nyan07/aura/README.md

# Arte-Luz-Interatividade: uma abordagem do uso da tecnologia na arte e da luz como material

Este repositório contém o meu trabalho de conclusão de curso do Bacharelado 
em Artes Visuais da Universidade Federal do Rio Grande do Sul - UFRGS.

Foi desenvolvido um trabalho que reune aplicações de arte e tecnologia 
utilizando Microsoft Kinect (input), Arduino (output) e um computador para
orquestrar o funcionamento destes dispositivos.

Trata-se de uma obra de arte interativa onde LEDs (presos ao teto em uma grade) 
acendem e apagam de acordo com a presença do espectador.

## Organização de diretórios
- `app` scripts em Processing referente ao trabalho prático
- `latex` monografia escrita em latex
- `talk` apresentação para a banca https://nyan07.github.io/aura/
