nyan07/aura/latex/03-elementos-pos-textuais/apendices.tex

%
% Documento: Apêndices
%

\begin{apendicesenv}

\chapter{Fotos da instalação}
\label{app:instalacao}

As fotos foram registradas após a apresentação final do trabalho, na Pinacoteca Barão de Santo Ângelo, com os interatores que estavam presentes.

\begin{figure}[H]
  \begin{center}
    \caption{Interações com o público em ambiente com baixa luminosidade 1}
    \vspace*{0,2cm}
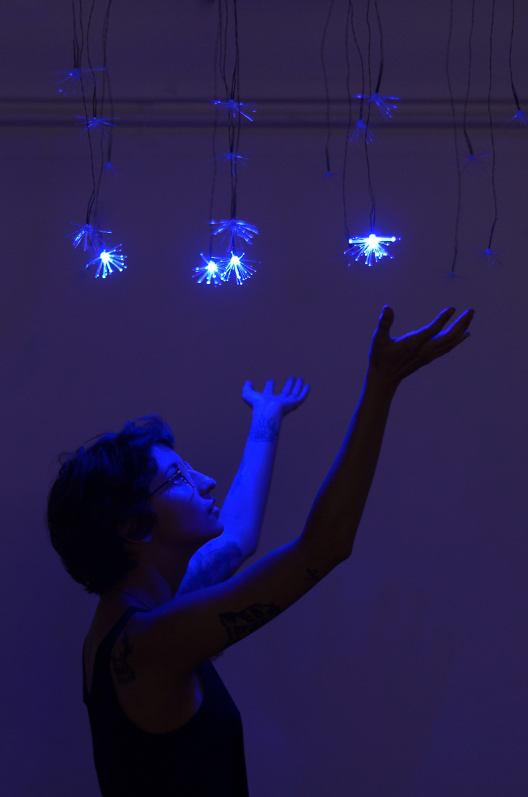
[picture p13: latex/04-figuras/instalacao_1.jpg]
    
    \label{fig:instalacao_1}
  \end{center}
  \vspace*{-0,9cm}
  \fonte{Elaborada pela autora}\\
\end{figure}

\begin{figure}[H]
  \begin{center}
    \caption{Interações com o público em ambiente com baixa luminosidade 2}
    \vspace*{0,2cm}
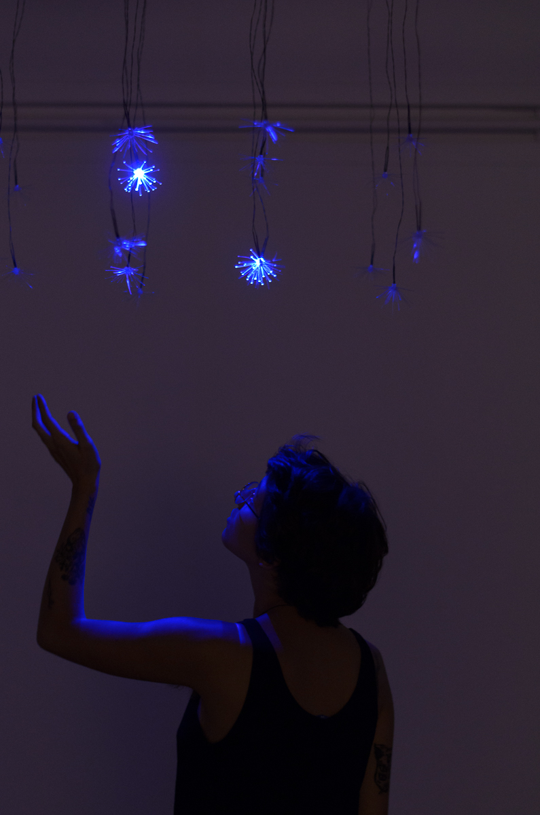
[picture p14: latex/04-figuras/instalacao_2.jpg]
    
    \label{fig:instalacao_2}
  \end{center}
  \vspace*{-0,9cm}
  \fonte{Elaborada pela autora}\\
\end{figure}

\begin{figure}[H]
  \begin{center}
    \caption{Interações com o público em ambiente com baixa luminosidade 3}
    \vspace*{0,2cm}
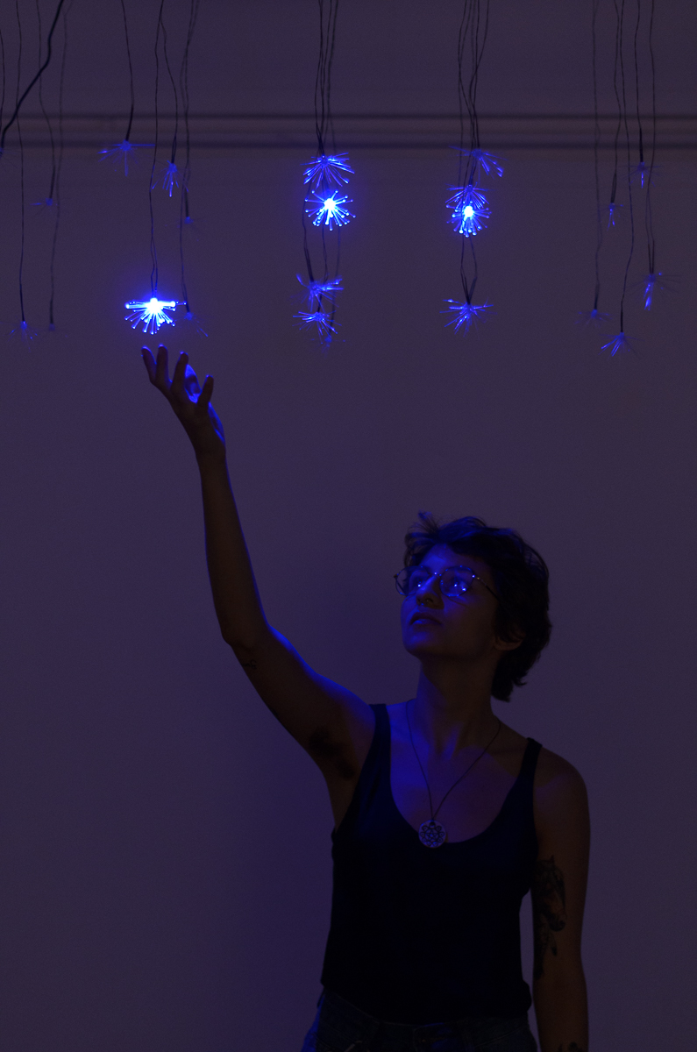
[picture p15: latex/04-figuras/instalacao_3.jpg]
    
    \label{fig:instalacao_3}
  \end{center}
  \vspace*{-0,9cm}
  \fonte{Elaborada pela autora}\\
\end{figure}

\begin{figure}[H]
  \begin{center}
    \caption{Interações com o público em ambiente com baixa luminosidade 4}
    \vspace*{0,2cm}
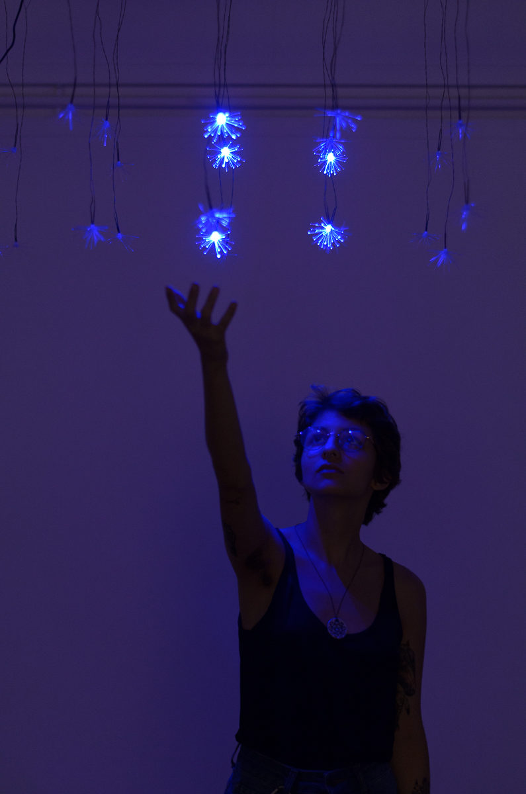
[picture p16: latex/04-figuras/instalacao_4.jpg]
    
    \label{fig:instalacao_4}
  \end{center}
  \vspace*{-0,9cm}
  \fonte{Elaborada pela autora}\\
\end{figure}

\begin{figure}[H]
  \begin{center}
    \caption{Vista da instalação em ambiente com baixa luminosidade}
    \vspace*{0,2cm}
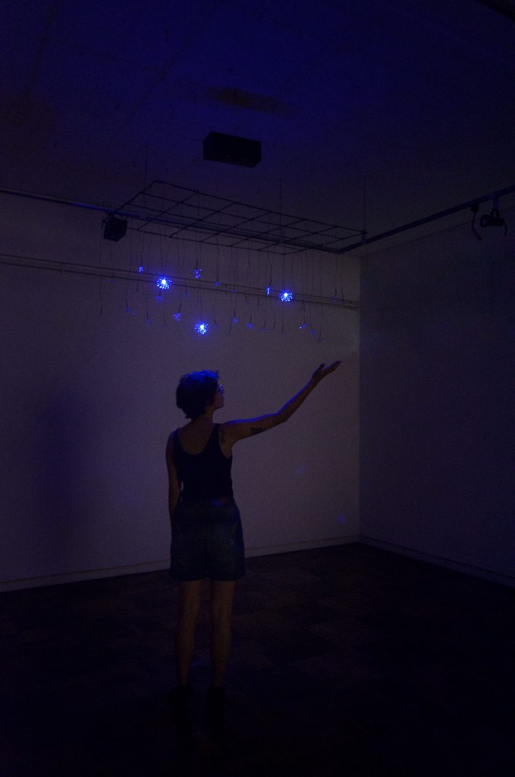
[picture p17: latex/04-figuras/instalacao_5.jpg]
    
    \label{fig:instalacao_5}
  \end{center}
  \vspace*{-0,9cm}
  \fonte{Elaborada pela autora}\\
\end{figure}

\begin{figure}[H]
  \begin{center}
    \caption{Interações com o público em ambiente com alta luminosidade 1}
    \vspace*{0,2cm}
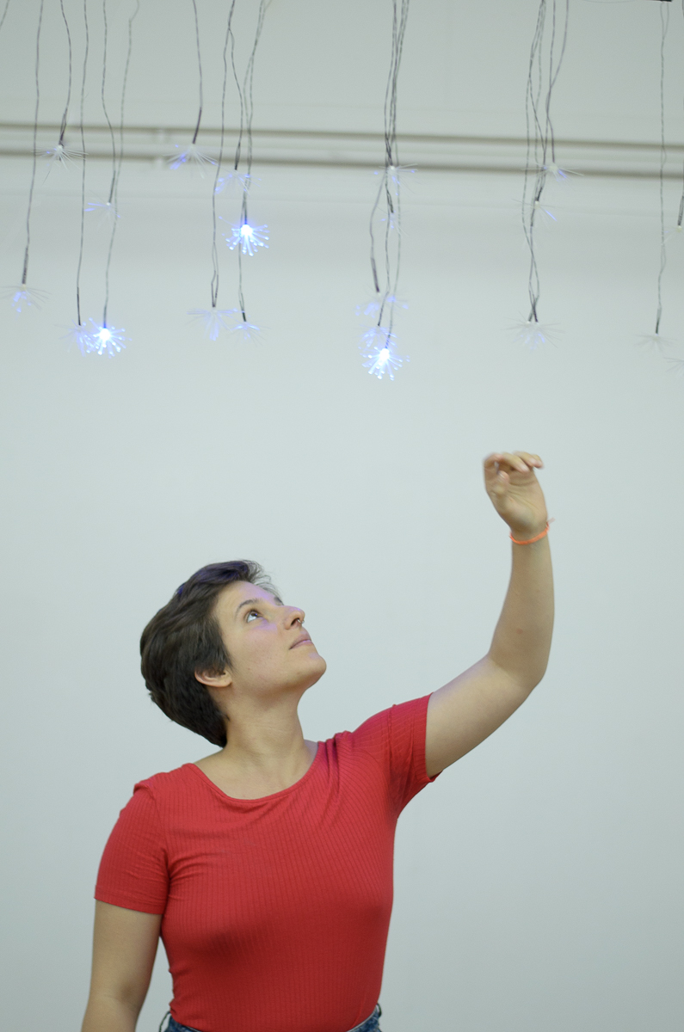
[picture p18: latex/04-figuras/instalacao_6.jpg]
    
    \label{fig:instalacao_6}
  \end{center}
  \vspace*{-0,9cm}
  \fonte{Elaborada pela autora}\\
\end{figure}

\begin{figure}[H]
  \begin{center}
    \caption{Interações com o público em ambiente com alta luminosidade 2}
    \vspace*{0,2cm}
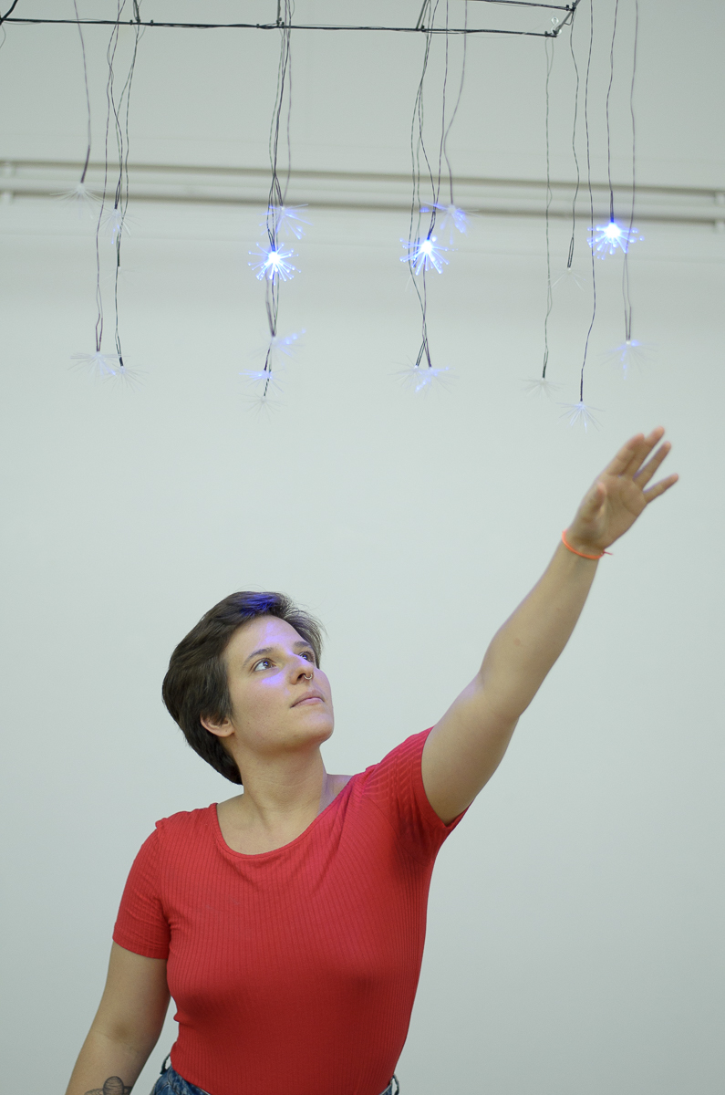
[picture p19: latex/04-figuras/instalacao_7.jpg]
    
    \label{fig:instalacao_7}
  \end{center}
  \vspace*{-0,9cm}
  \fonte{Elaborada pela autora}\\
\end{figure}

\begin{figure}[H]
  \begin{center}
    \caption{Vista da instalação em ambiente com alta luminosidade}
    \vspace*{0,2cm}
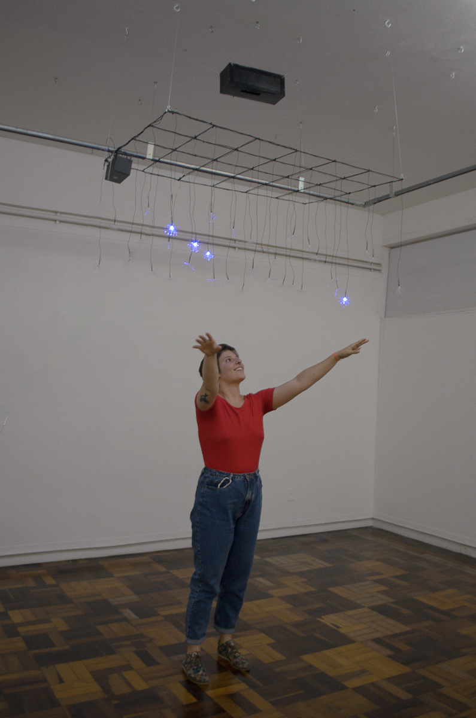
[picture p20: latex/04-figuras/instalacao_8.jpg]
    
    \label{fig:instalacao_8}
  \end{center}
  \vspace*{-0,9cm}
  \fonte{Elaborada pela autora}\\
\end{figure}

\end{apendicesenv}
