nyan07/aura/latex/01-elementos-pre-textuais/listaSiglas.tex

%
% Documento: Lista de abreviaturas e siglas
%

\begin{siglas}
  \setlength{\baselineskip}{0.7\baselineskip}
  
  \item[FPS] \textit{Frames per Second} (Quadros por Segundo)
  \item[IDE] \textit{Integrated Development Environment} (Ambiente de Desenvolvimento Integrado)
  \item[IR] Infrared radiation (Radiação infravermelha)
  \item[LED] \textit{Light-emitting Diode} (Diodo Emissor de Luz)
  \item[RGB] R. \textit{Red}: Vermelho, G. \textit{Green}: Verde, B. \textit{Blue}: Azul
  \item[UFRGS] Universidade Federal do Rio Grande do Sul
  \item[USB] \textit{Universal Serial Bus}
\end{siglas}
