nyan07/aura/latex/01-elementos-pre-textuais/capa.tex

%
% Documento: Capa
%

\makeatletter
\begin{capa}
	\thispagestyle{empty}%limpa estilo da pagina
	\setlength{\baselineskip}{0.72\baselineskip}
    \begin{center} %Alinhamento centralizado
	
    \textbf{\expandafter\uppercase\expandafter{\imprimirinstituicao}}\\
    \textbf{\expandafter\uppercase\expandafter{\imprimirdepartamento}}\\
    \textbf{\expandafter\uppercase\expandafter{\imprimirprograma}}\\
	\vspace*{5cm}%Espaçamento entre linhas

	\large\textbf{\expandafter\uppercase\expandafter{\imprimirtitulotb}}{:}
	\large\textbf{\expandafter\uppercase\expandafter{\imprimirsubtitulo}}\\
	
	\vspace*{6cm}%Espaçamento entre linhas	
	\small\textbf{\expandafter\uppercase\expandafter{\imprimirnomeautor}}\\
	\vspace*{9cm}%%Espaçamento entre linhas
	\small\textbf{\expandafter\uppercase\expandafter{\imprimirlocal}}\\
	\small\textbf{\expandafter\uppercase\expandafter{\imprimirdata}}\\		
	\end{center} %Alinhamento centralizado
\end{capa}
\makeatother
