nyan07/aura/latex/01-elementos-pre-textuais/folhaAprovacao.tex

%
% Documento: FOLHA APROVAÇÃO
%

\makeatletter
\begin{folhadeaprovacao}

\thispagestyle{empty}%limpa estilo da pagina
	
	\begin{center}
    
		\small\textbf{\expandafter\uppercase\expandafter{\imprimirnomeautor}}\\
		\vspace*{8.2 cm}%Espaço entre linhas
		\normalsize\textbf{\expandafter\uppercase\expandafter{\imprimirtitulotb}}{:}
		\normalsize\textbf{\expandafter\uppercase\expandafter{\imprimirsubtitulo}}\\
    \end{center}
	
	\vspace*{0.35 cm}%Espaçamento entre linhas
		    \large%tamanho da fonte 
    		\hfill%Estica horizontamente  com espaços
	    	\begin{minipage}{8 cm}%Minipagina
	    		\begin{small} %Muda tamanho da fonte
	    		\setlength{\baselineskip}{0.7\baselineskip}
				
				{Trabalho de conclusão apresentado à banca do Curso de {\imprimircurso} – {\imprimirprograma } do {\imprimirdepartamento} da {\imprimirinstituicao}, como requisito obrigatório para obtenção do título de {\imprimirgrau} em {\imprimircurso}.}\\
				
				\end{small} %Muda tamanho da fonte
		    \end{minipage}%%Minipagina

		    \vspace*{0.6 cm}%Espaçamento entre linhas
		    
		    \large%%tamanho da fonte 
    		\hfill%%Estica horizontamente  com espaços

		    \normalsize %Muda tamanho da fonte
		    \vspace*{1.5 cm}%Espaçamento entre linhas
		    
		    %\begin{minipage}{9 cm }%%Minipagina
		    
		    \noindent{Porto Alegre,}{ }{\imprimirdataapresentacao}\\
		    %\end{minipage}%Minipagina
			
          % \begin{center}%Alinhamento centralizado
		   % \vspace*{1.21 cm}%Espaçamento entre linhas
		   % \textbf{Banca Examinadora}\\ %Negrito
						
			\vspace*{2 cm}%Espaçamento entre linhas
			\noindent\rule{9 cm}{.1 mm}\\
			\imprimirtitulacaoorientador{ }\imprimirorientador{ }- Orientador\\
			
			\vspace*{1 cm}%Espaçamento entre linhas
			\noindent\rule{9 cm}{.1 mm}\\
			\imprimirtitulacaoexamum{ }\imprimirnmexamum{ }- Banca examinadora\\
				
			\vspace*{1 cm}%Espaçamento entre linhas
			\noindent\rule{9 cm}{.1 mm}\\	
			\imprimirtitulacaoexamdois{ }\imprimirnomeexamdois{ }- Banca examinadora\\			

\end{folhadeaprovacao}
\makeatother
