nyan07/aura/latex/06-quadros/quaexemplo.tex

\begin{quadro}[H]

	\begin{center}
	\caption{Exemplo para quadro.\label{qua:quaexe}}
		\begin{tabular}{|p{7cm}|p{7cm}|}
			\hline
			("Trabalho Conclusão de Curso")\\
			\hline
		\end{tabular}
	\end{center}
	\vspace*{-0,8cm}

	{\raggedright \fonte{Autor desta monografia, 2015.}}
	
\end{quadro}
