nyan07/aura/latex/01-elementos-pre-textuais/agradecimentos.tex

\begin{agradecimento}

Agradeço à Desiree Santos e ao Igor Balteiro que colaboraram com a execução da obra apresentada. Sem suas contribuições, ideias e incentivo este trabalho não seria possível. 

À ThoughtWorks pelo espaço na sala Mão na Massa, onde trabalhei ao longo do ano, e por ceder parte dos equipamentos utilizados.

À Gisele Ramires que teve papel fundamental na minha jornada durante a graduação e muito mais que uma colega, se tornou uma amiga. 

Ao Felipe de Morais por me incentivar, apoiar e acreditar em mim. 

Ao Ricardo Cantergi pelo carinho e suporte nos momentos mais difíceis que tive nos últimos anos do curso. 

Agradeço também aos membros da banca pelo tempo dedicado. Profa. Dra. Alessandra Lucia Bochio e Profa. Dra. Marina Bortoluz Polidoro, que através de pontuações incríveis agregaram valor imensurável a este trabalho.

Ao meu orientador, Alberto, pela confiança depositada.

\end{agradecimento}
