nyan07/aura/latex/01-elementos-pre-textuais/preambulo.tex

%
% Documento: Preâmbulo
%

\instituicao{Universidade Federal do Rio Grande do Sul}
\abreviatura{UFRGS}
\departamento{Instituto de Artes}
\local{Porto Alegre}
\programa{Bacharelado em Artes Visuais}
\nomeautor{Daniela Feitosa Araújo}
\titulotb{Arte-Luz-Interatividade}
\subtitulo{Uma abordagem do uso da tecnologia na arte e da luz como material}
\data{2018}
\grau{Bacharel}
\dataapresentacao{dezembro de 2018}
\curso{Artes Visuais}

%Dados Orientador
\orientador{Alberto Marinho Ribas Semeler}
%\coorientador{Anderson Black}
\instOrientador{UFRGS}
\departamentoorientador{Artes Visuais}
\titulacaoorientador{Prof. Dr.}

%Dados Examinador 1
\nmexamum{Alessandra Lucia Bochio}
\instexamum{UFRGS}
\departamentoexamum{Instituto de Artes}
\titulacaoexamum{Profa. Dra.}

%Dados Examinador 2
\nomeexamdois{Marina Bortoluz Polidoro}
\instexamdois{UFRGS}
\departamentoexamdois{Instituto de Artes}
\titulacaoexamdois{Profa. Dra.}
