nyan07/aura/latex/01-elementos-pre-textuais/epigrafe.tex

%
% Documento: Epígrafe
%
\thispagestyle{empty}
\begin{epigrafe}

"Às vezes olhar para o futuro pode ser assustador porque por definição ele é desconhecido. Mas com arte e tecnologia podemos contar histórias reais sobre o que está por vir e trazer nitidez para essas questões."
{\\}{\\}

\begin{autorepigrafe}
Andrew McWilliams - TEDxVilnius
\end{autorepigrafe}

\end{epigrafe}
