nyan07/aura/latex/01-elementos-pre-textuais/listaAlgoritmos.tex

%
% Documento: Lista de algoritmos
%

\newcommand{\algoritmoname}{Algoritmo}
\renewcommand{\listalgorithmcfname}{Lista de Algoritmos}

\floatname{algocf}{\algoritmoname}
\newlistof{listofalgoritmos}{loa}{\listalgoritmoname}
\newlistentry{algocf}{loa}{0}

\counterwithout{algocf}{chapter}
\renewcommand{\cftalgocfname}{\algoritmoname\space}
\renewcommand*{\cftalgocfaftersnum}{\hfill--\hfill}

\pdfbookmark[0]{\listalgorithmcfname}{loa}
\listofalgorithms
\cleardoublepage
