nyan07/aura/latex/01-elementos-pre-textuais/listaFiguras.tex

%
% Documento: Lista de figuras
%

\pdfbookmark[0]{\listfigurename}{lof}
\listoffigures*
\cleardoublepage
