nyan07/aura/latex/01-elementos-pre-textuais/listaSimbolos.tex

%
% Documento: Lista de símbolos
%

\begin{simbolos}
    \item[$ \Gamma $] Letra grega Gama
    \item[$ \lambda $] Comprimento de ondada
    \item[$ \in $] Pertence
\end{simbolos}
