nyan07/aura/latex/04-figuras/jim_campbell.jpg

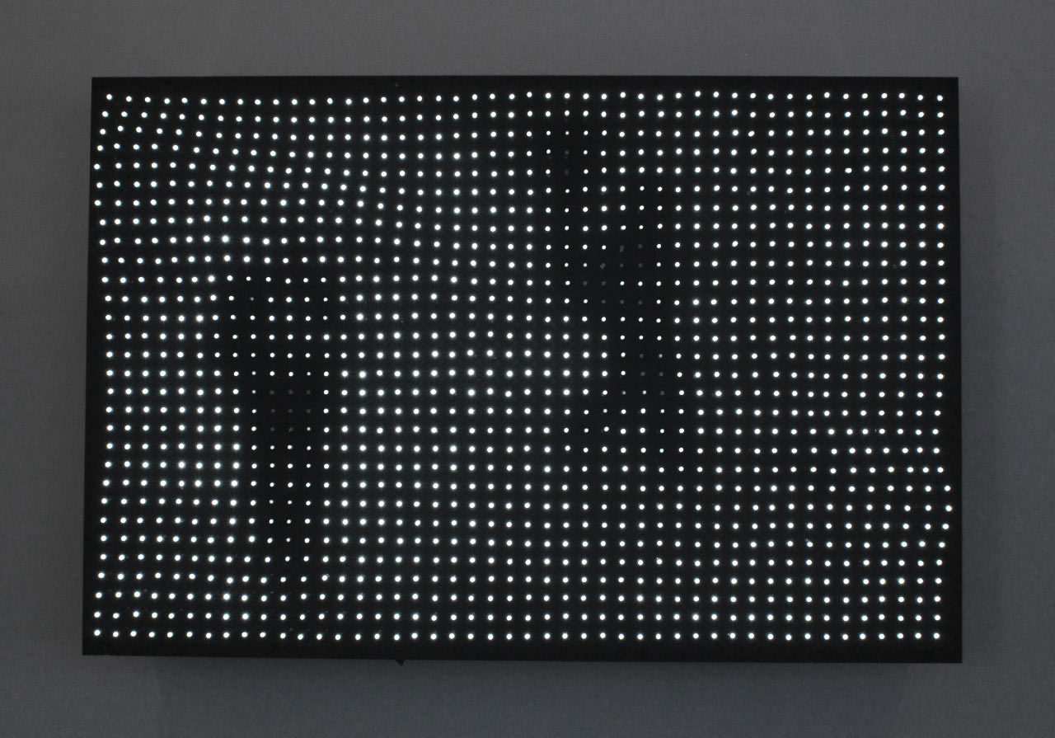
latex/04-figuras/jim_campbell.jpg
