nyan07/aura/latex/04-figuras/leds.jpg

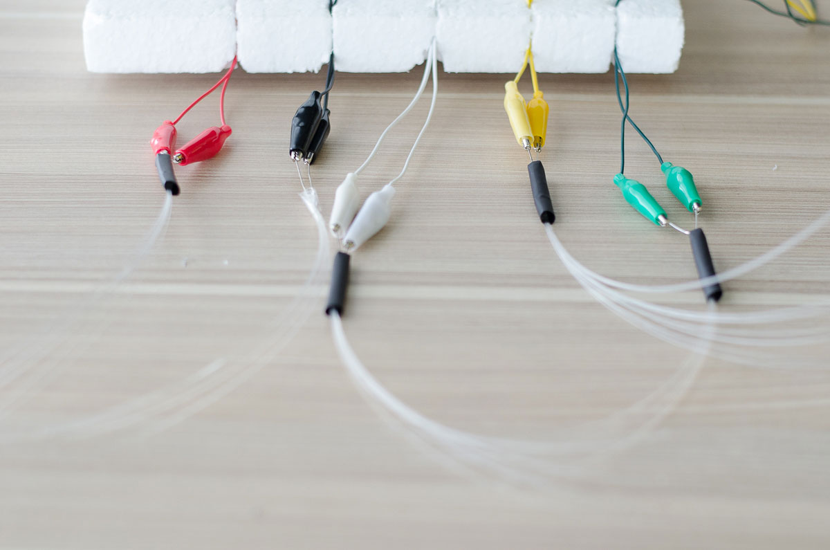
latex/04-figuras/leds.jpg
