nyan07/aura/latex/04-figuras/seurat_la_parede.jpg

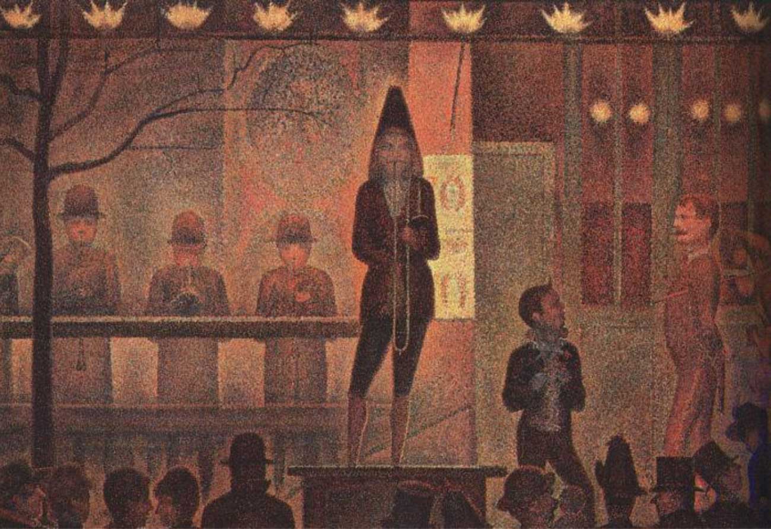
latex/04-figuras/seurat_la_parede.jpg
