nyan07/aura/latex/04-figuras/seurat_la_parede_detalhe.jpg

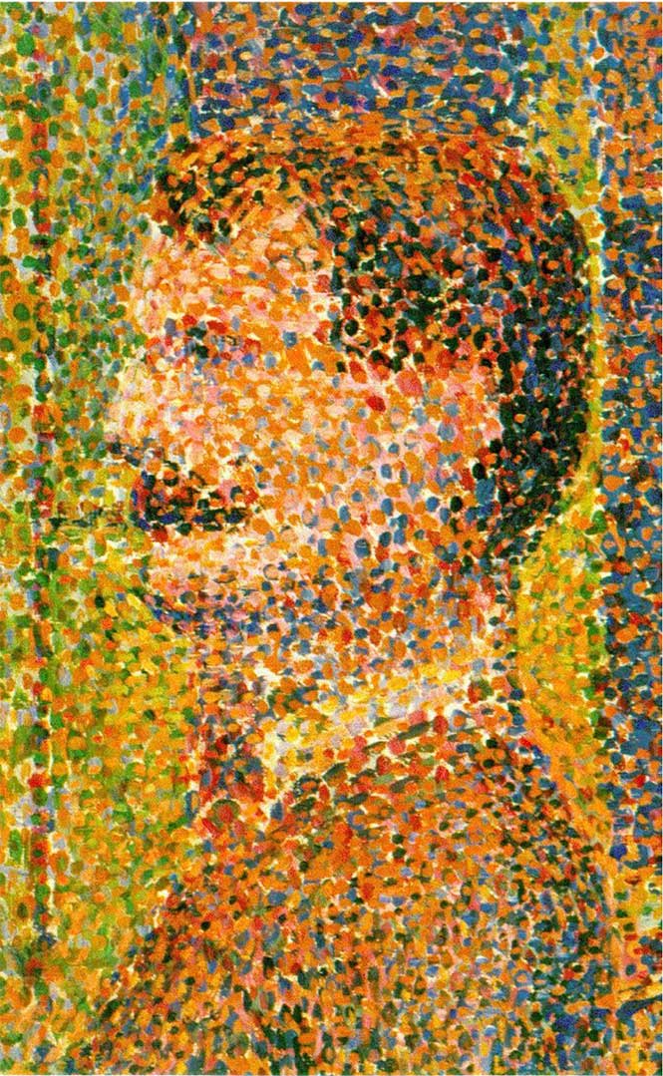
latex/04-figuras/seurat_la_parede_detalhe.jpg
