nyan07/aura/latex/04-figuras/takahito_matsuo.jpg

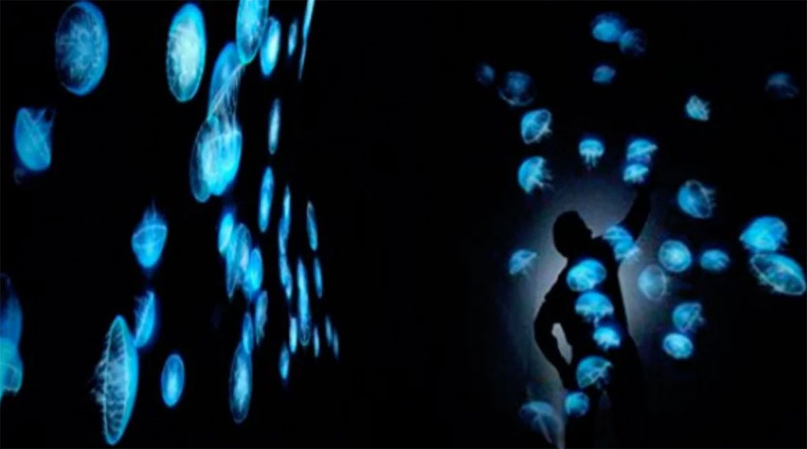
latex/04-figuras/takahito_matsuo.jpg
