nyan07/aura/latex/04-figuras/tsutomu_mutoh.jpg

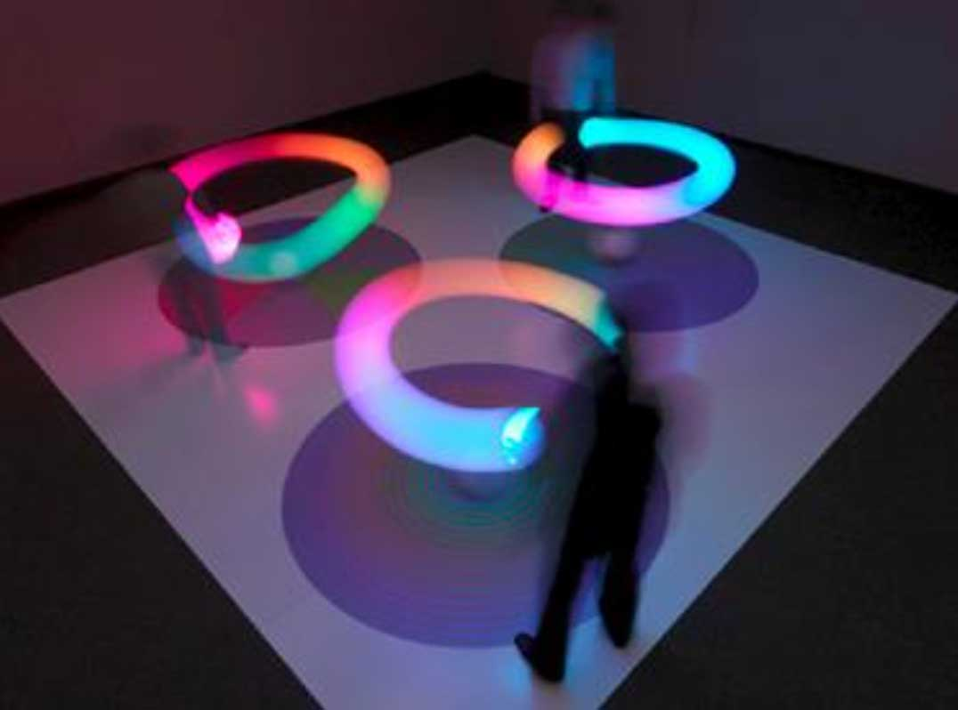
latex/04-figuras/tsutomu_mutoh.jpg
