nyan07/aura/talk/images/seurat_la_parede.png

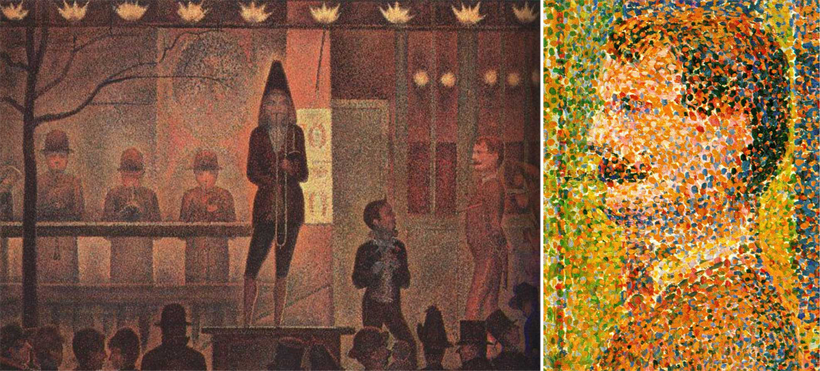
talk/images/seurat_la_parede.png
