nyan07/aura/(commit log)

2018-05-30 Communicate Kinect and Arduino
2018-06-04 Some changes to work with the fisrt prototype
2018-06-07 Corrige capa e folha de rosto / adiciona lista de figuras
2018-06-07 Altera configurações e ajusta formatação de citação longa
2018-06-12 WIP: A luz como material e o cubo preto
2018-06-12 WIP: Arduino e malha de LEDs
2018-06-16 Revisão de texto. Primeira prévia enviada ao orientador.
2018-06-18 WIP: a luz como material
2018-06-22 Revisão do texto luz como material
2018-06-22 Revisa texto de composição da obra
2018-06-30 Ajusta direção dos leds
2018-07-01 Revisão final e redimensionamento de imagens
2018-07-01 Esqueleto da apresentação para a pré-banca
2018-07-02 Adicionado trabalhos de Jim Campbell na apresentação
2018-07-02 Troca do template da apresentação e revisão da estrutura de introdução
2018-07-02 Adicionado trabalho de James Turrell na apresentação
2018-07-02 Adicionado trabalho de Takahito Matsuo na apresentação
2018-07-12 Adiciona sessão sobre o papel do corpo do espectador na obra de arte
2018-07-12 Adicionadas referencias de Vares e Rabello
2018-07-12 Adicionadas referencias de Witt
2018-07-13 Estruturado conteúdo sobre o corpo do observador na obra de arte interativa
2018-07-14 Revisão do texto O corpo do observador na obra de arte interativa
2018-07-14 Adicionada referencia de Sogabe sobre instalações interativas
2018-07-14 Ajuste de palavras-chave
2018-07-14 Adicionada imagem de experimento de leds + fibra ótica
2018-07-14 Adicionada referencia a imagem de LED + Correções em bibliografia
2018-07-14 Atualizada imagem de leds e fibra ótica
2018-07-14 Move interação e participação para capitulo sobre arte computacional e interatividade
2018-07-19 Adiciona subseção graus de interatividade e revisa da contemplação à interação
2018-07-19 Adiciona configuração para não repetir nome de autor nas referências
2018-07-22 Desenvolvimento de graus de interatividade
2018-07-22 Revisão graus de interatividade
2018-07-23 Revisão de instalações interativas
2018-08-12 Introdução de a luz como material
2018-08-15 Revisão de a luz como material
2018-11-06 ALtera imagem da malha de leds e revisa texto sobre o projeto.
2018-11-09 Cria uma matriz de pontos controlados pelo kinect.
2018-11-09 Revisa texto do projeto e adiciona imagem de arduino mega.
2018-11-10 Controla arduino (leds) a partir do script.
2018-11-10 Aplica configuração de portas.
2018-11-10 Adiciona imagem para explicação de como funciona o script.
2018-11-11 Revisão de texto e imagens
2018-11-11 Revisão de trabalhos futuros.
2018-11-11 Ajusta fonte de imagens
2018-11-12 Adicionada sigla para infravermelho
2018-11-12 Ajusta titulos de subseções
2018-11-13 Corrige posicionamento da grade no script
    [Aura.pde]
2018-11-13 Revisa a luz como material
2018-11-15 Atualiza esquema de montagem da obra e corrige referencia a imagem
2018-11-15 Atualiza imagem de exemplo de captura do kinect.
2018-11-26 Atualiza apresentação com notas para o revisor
2018-11-27 Versão final enviada para a banca.
